eimparas/Electronic-DC-Load/Hardware/README.md

# Details about the design

## Analog Power Frontend
> Where the "work" happens

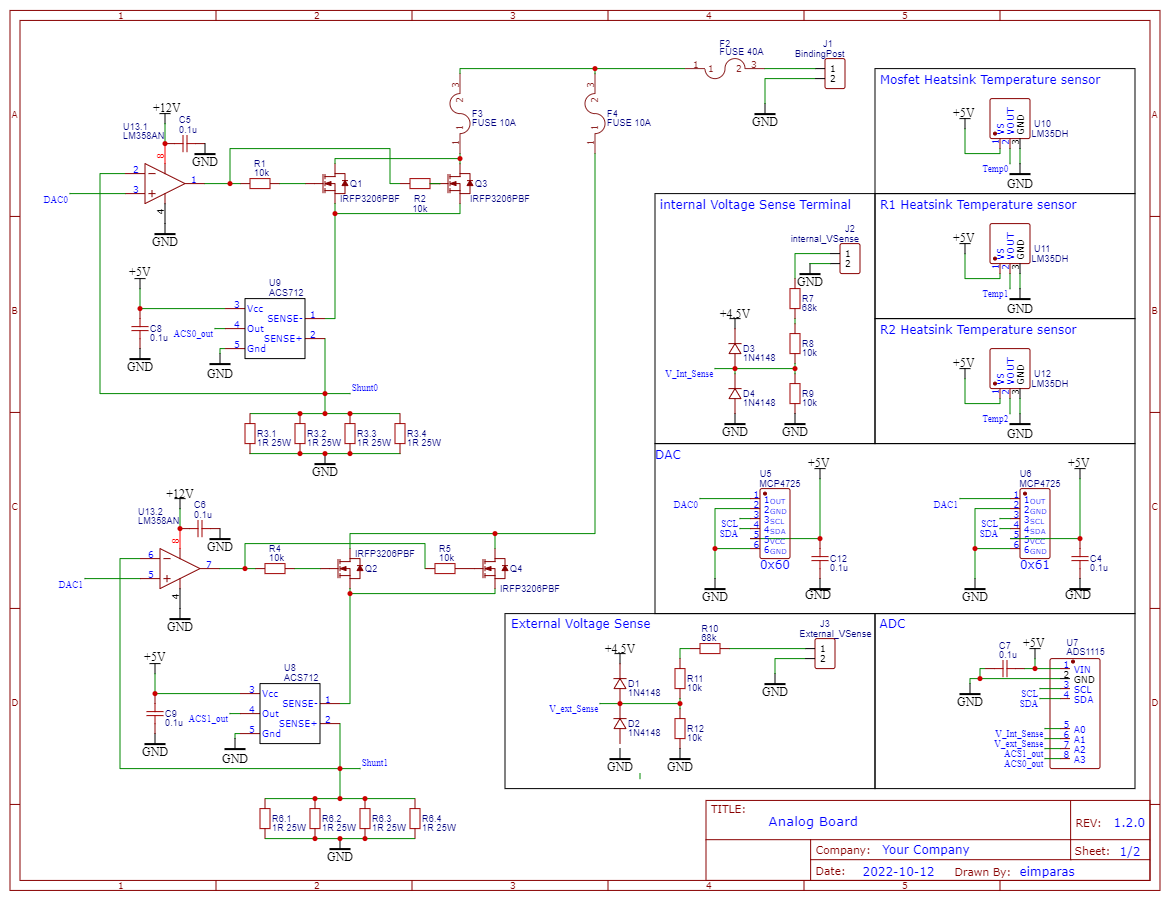
[picture p1: IMG/Analog_Power_Schematic.png]
Frontend


## Digital Control 
> adding the logic

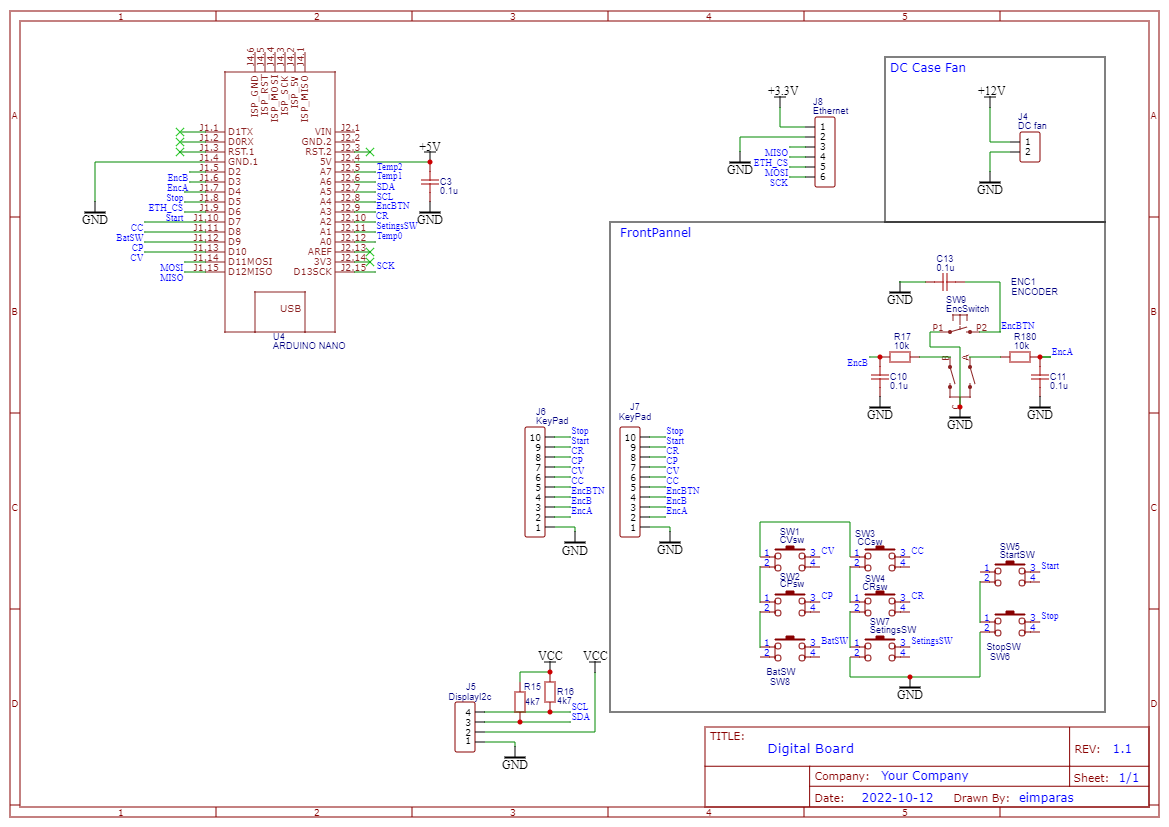
[picture p2: IMG/Digital_Control_Schematic.png]
Digital
