eimparas/Electronic-DC-Load/Specifications.md

|Voltage|Current|Maximum Power|Minimum Operating Voltage (DC)|
|-|-|-|-|
|1|2|3|4|

# Specifications
|Modes|Range|Programmable Resolution|Programmable Accuracy|
|-|-|-|-|
|CC|2|3|4|
|CV|
|CP|
|CR|
