eimparas/Electronic-DC-Load/IMG/Power Supply.png

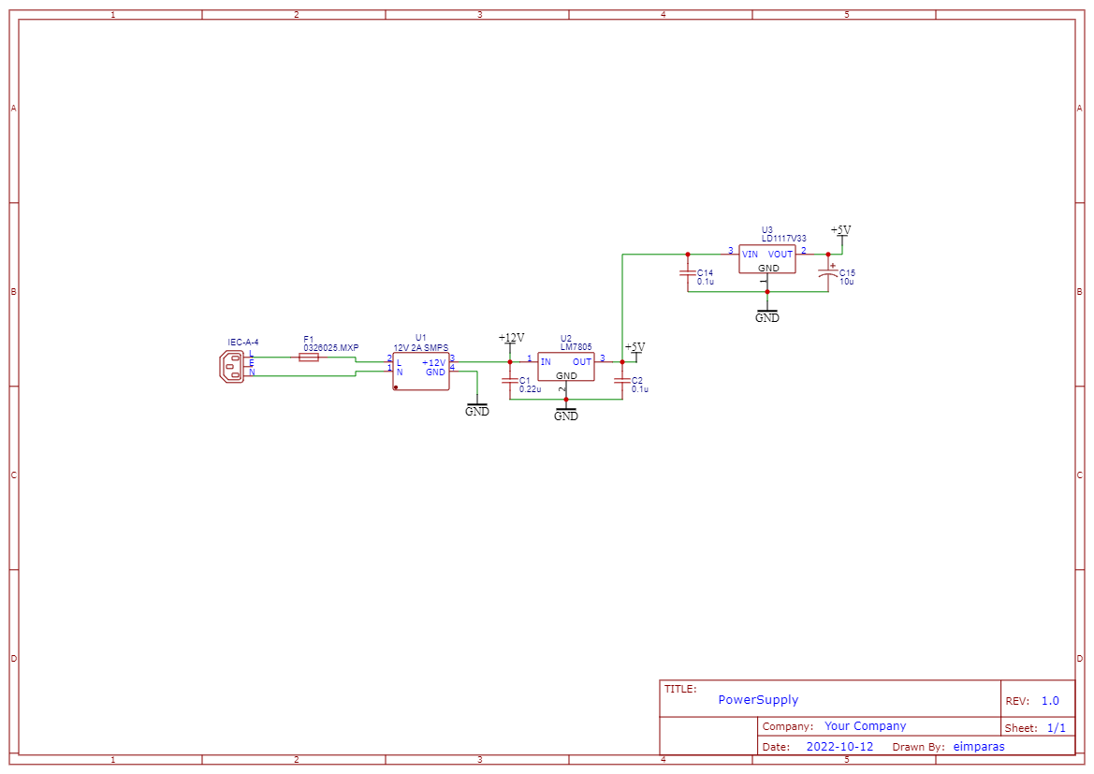
IMG/Power Supply.png
