eimparas/Electronic-DC-Load/Hardware/BOM.md

|ID |Name |Designator |Footprint |Quantity|
|---|---|---|---|---|
|1  |0.22u |C1 |TANT_A |1 |
|2  |0.1u |C2,C3,C4,C5,C6,C7,C8,C9,C10,C11,C12,C13,C14|C0603 |13 |
|3  |10u |C15 |CASE-A_3216 |1 |
|4  |1Ν4148 |D1,D2,D3,D4 |SOD-123_L2.8-W1.8-LS3.7-RD |4 |
|5  |ENCODER |ENC1 |PEC12_INCREMENTAL_ENCODER |1 |
|6  |0326025.MXP |F1 |FUSE-SMD_LITTELFUSE-0326025 |1 |
|7  |FUSE 40A |F2 |FUSE_5MM |1 |
|8  |FUSE 10A |F3,F4 |FUSE_5MM |2 |
|9  |BindingPost |J1 |HDR-F-2.54_1X2 |1 |
|10 |internal_VSense|J2 |HDR-F-2.54_1X2 |1 |
|11 |External_VSense|J3 |HDR-F-2.54_1X2 |1 |
|12 |DC fan |J4 |HDR-F-2.54_1X2 |1 |
|13 |DisplayI2c |J5 |HDR-M-2.54_1X4 |1 |
|14 |KeyPad |J6,J7 |HDR-M-2.54_1X10 |2 |
|15 |Ethernet |J8 |HDR-F-2.54_1X6 |1 |
|16 |IEC-A-4 |LINE1 |IEC-A-4 |1 |
|17 |IRFP3206PBF |Q1,Q2,Q3,Q4 |TO-247AC-3_L15.8-W5.0-P5.46-L  |4 |
|18 |10k |R1,R2,R4,R5,R8,R9,R11,R12,R17,R180 |RC06 |10 |
|19 |68k |R7,R10 |RC06 |2 |
|20 |4k7 |R15,R16 |RC06 |2 |
|21 |CVsw |SW1 |SW-SMD_4P-L6.0-W6.0-P3.90-LS9.5|1 |
|22 |CPsw |SW2 |SW-SMD_4P-L6.0-W6.0-P3.90-LS9.5|1 |
|23 |CCsw |SW3 |SW-SMD_4P-L6.0-W6.0-P3.90-LS9.5|1 |
|24 |CRsw |SW4 |SW-SMD_4P-L6.0-W6.0-P3.90-LS9.5|1 |
|25 |StartSW |SW5 |SW-SMD_4P-L6.0-W6.0-P3.90-LS9.5|1 |
|26 |StopSW |SW6 |SW-SMD_4P-L6.0-W6.0-P3.90-LS9.5|1 |
|27 |SetingsSW |SW7 |SW-SMD_4P-L6.0-W6.0-P3.90-LS9.5|1 |
|28 |BatSW |SW8 |SW-SMD_4P-L6.0-W6.0-P3.90-LS9.5|1 |
|29 |EncSwitch |SW9 |PEC12_INCREMENTAL_ENCODER |1 |
|30 |12V 2A SMPS |U1 |PWRM-TH_VB05-T2S12 |1 |
|31 |LM7805 |U2 |TO-220-3_L10.2-W4.5-P2.54-L |1 |
|32 |LD1117V33 |U3 |TO-220-3_L10.0-W4.5-P2.54-L |1 |
|33 |ARDUINO NANO |U4 |ARDUINO-NANO-3.0#ISP |1 |
|34 |MCP4725 |U5,U6 |MCP4725-B |2 |
|35 |ADS1115 |U7 |ADS1115 ADAFRUIT |1 |
|36 |ACS712 |U8,U9 |ACS712 |2 |
|37 |LM35DH |U10,U11,U12 |TO-CAN-3_BD5.5-P1.27-L |3 |
|38 |1R 25W |R3,R6 |RC42 |2 |
|39 |LM358AN |U13 |DIP-8_L9.8-W6.6-P2.54-LS7.6-BL |1 |
