eimparas/Electronic-DC-Load/Hardware/Schematics/Analog Power-frontend.pdf

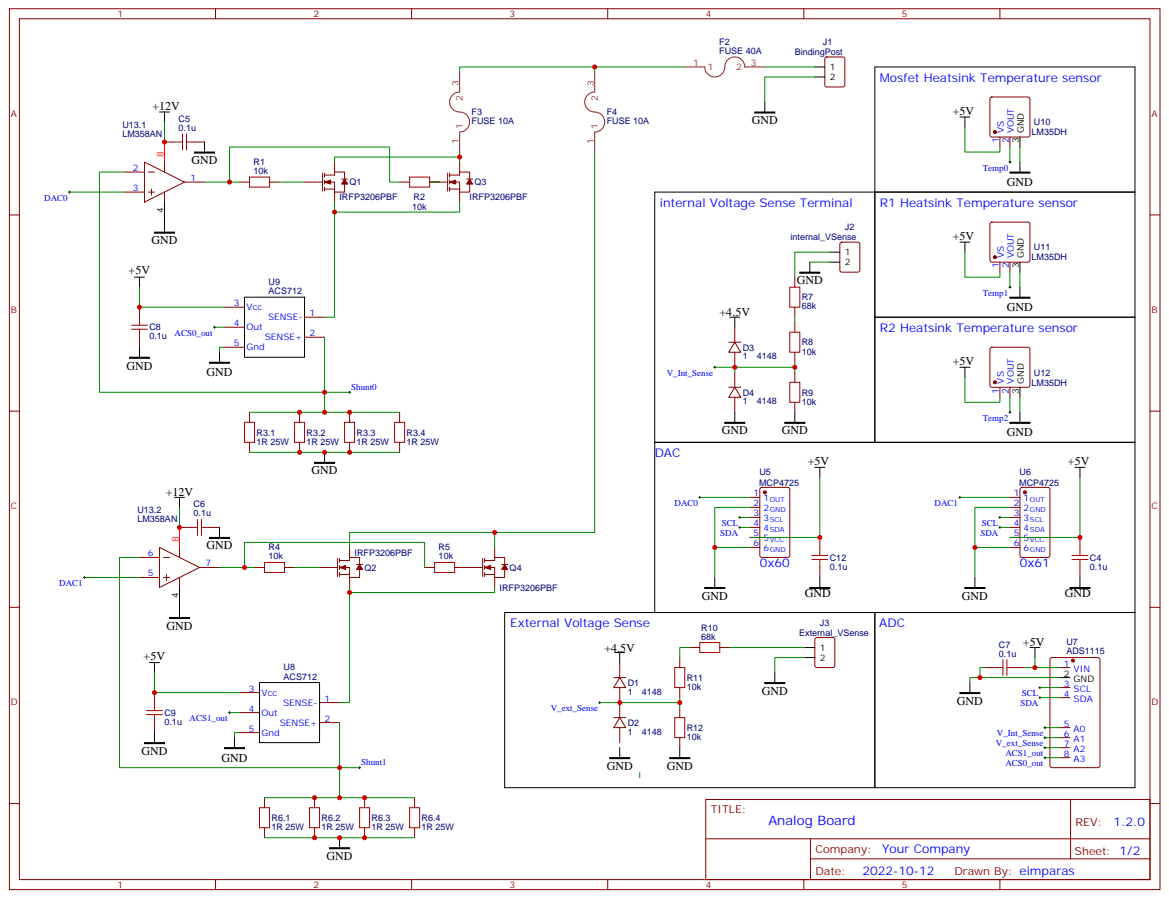
[picture p4: page 1]

Mosfet Heatsink Temperature sensor

internal Voltage Sense Terminal
