eimparas/Electronic-DC-Load/Hardware/Schematics/Digital Control.pdf

## DC Case Fan

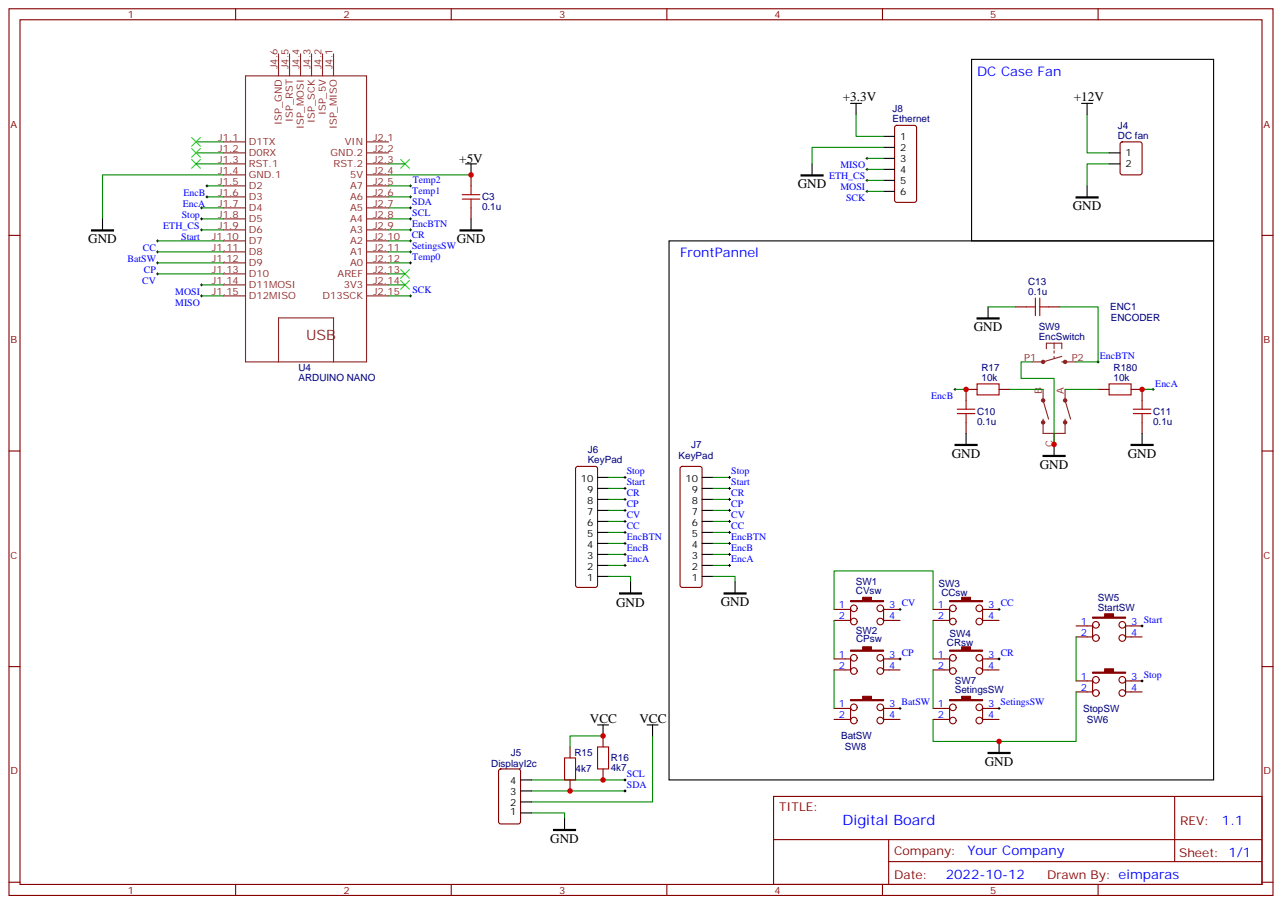
[picture p5: page 1]
