eimparas/Electronic-DC-Load/Hardware/Schematics/Power Supply.pdf

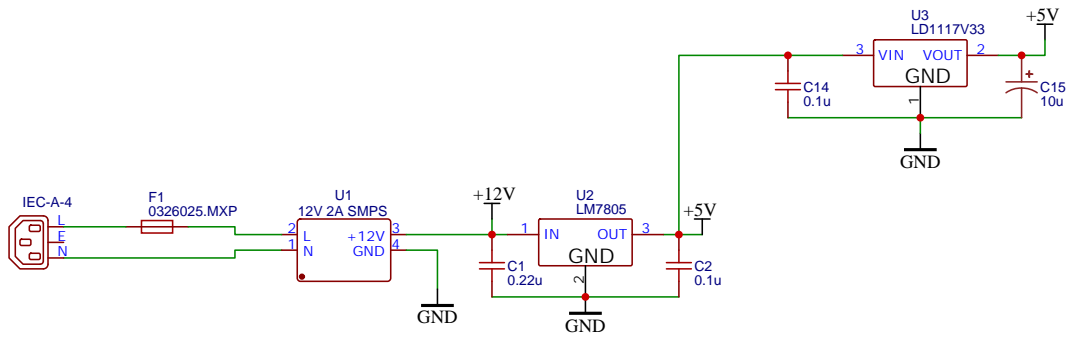
[picture p6: page 1]
