eimparas/Electronic-DC-Load/Firmware/ElectronicDCload/pinout.h

#ifndef PINOUT_H
#define PINOUT_H
#include <Arduino.h>
#endif

#define LCDaddr 0x27
#define ADCaddr 0x48
#define DAC1addr 0x62
#define DAC2addr 0x63



byte R[] = {
  B11111,
  B10011,
  B10101,
  B10011,
  B10101,
  B10101,
  B10101,
  B11111
};

byte V[] = {
  B11111,
  B11111,
  B10101,
  B10101,
  B10101,
  B11011,
  B11111,
  B11111
};

byte I[] = {
  B11111,
  B10001,
  B11011,
  B11011,
  B11011,
  B11011,
  B10001,
  B11111
};
byte C[] = {
  B11111,
  B11011,
  B10101,
  B10111,
  B10111,
  B10101,
  B11011,
  B11111
};
byte V2[] = {
  B11111,
  B10101,
  B10101,
  B10101,
  B10101,
  B10101,
  B11011,
  B11111
};//Noice

byte W[] = {
  B11111,
  B01110,
  B01110,
  B01110,
  B01010,
  B01010,
  B10001,
  B11111
};

byte A[] = {
  B10001,
  B01110,
  B01110,
  B01110,
  B00000,
  B01110,
  B01110,
  B11111
};

///
//Pins definitions , Use same names on schematics.
///

//encoder
#define EncA 2
#define EncB 3
#define EncBTN A3

//SCPI ethernet SPI cs
#define ETH_CS 5


//StartStopButtons
#define StopBtn 4 
#define StartBtn 6 


//modeButtons
#define CVbtn 10
#define CCbtn 7
#define CPbtn 9
#define CRbtn A2
#define BATsw 8

//SettingsSW
#define settingsSW A1

//LM35 HeatSink temperature Sensor
#define Temp0 A0
#define Temp1 A6
#define Temp2 A7//Mosfet

///
// Component Constants , Use same Names on schematics
///


//Voltage Divider Restistor Values

#define R7 68000
#define R8 10000
#define R9 10000//Internal Voltage Sense

#define R10 68000
#define R11 10000
#define R12 10000//External Voltage Sense
