eimparas/Electronic-DC-Load/(commit log)

2022-10-12 fixes in schematic export
2022-10-14 Pin Initialzations , initial rottery encoder function
    Rottery encoder is acting up , propably debuncing issue.
    [FrontPanel.ino, pinout.h]
2022-10-15 Working Encoder Code in `/Encoder` folder
2022-11-23 Changed shunt R, removed MUX , changed Current sense location
    With this arangement the circut can draw up to 20A per mosfet , this schematic has only one fet , can be scaled up .
    to measure total Current sum the `ACS_out` adc ports.
2022-12-08 Increased Current Capability , changed protection circuits
    Added a more effectvie way to protect the ADC from reverse or high voltages , removed the Emengercy button due to front pannel space , added 2 new temp sensors for the 2 new heatsinks . Removed the reading of Shunt voltage from the arduino's adc , we are just using now the ACS712 reading , since we updated the topology to support more amps.
2022-12-08 Working ADC example code
    working ADS1115 test code.Using the library from https://github.com/RobTillaart/ADS1X15 . This example is just some initial tests and exploration of the IC and its capabilities
2022-12-08 Initial Rottery encoder Tests
    using both External & PCint .
2022-12-08 Initial merge of Functions. GUI is formed .
    This is reference code for working LCD , rottery encoder , front pannel buttons .
2022-12-08 LM35 reports correct temperature . To be merged
2022-12-08 The first merge
    Mosfet Channel Control works, Voltage reading works but reports false info , Voltage divider equasion needs to be input, No Amps reading possibly Software issue.
    [TheFireTest.ino, pinout.h]
2023-01-12 Added mosfets in paralel in each channel
    To cunteract the huge power output of each mosfet, and bring it to a managable level i added a 2nd mosfet in paralel for each channel .
2023-01-20 Fixed component designators , Schematic cleanup ,
    Changed button order in BOM
2023-01-20 Added 3v3 regulator for Ethernet Controler
2023-02-24 Working CodeBase for atmega4809
    Operational:
    DAC
    ADC
    Screen
    Ethernet
    Initial SCPI parser
    ACS calibration function.
    0 CV,CC,CR,CP algorythms TBA
2023-02-25 Added Start Stop , Initial ModeButton BringUp ,
    Cleaned up code ,
    Added start Stop functionality
    Initial Mode button functionality , they are out of order ,work needed.
2023-02-26 Updated pin definitions
    - Added `A` character
    - Moved `CCbtn` from `D9` to `D7`
    - Moved `CPbtn` from `D8` to `D9`
    - Moved `CRbtn` from `D7` to `A2`
    - Renamed `BATbtn` to `BATsw` to match schematic
2023-02-26 Fixed mode swiching UI .
    Added pin initalzation for Battery modeButton
    Fixed mode swiching , issues with flickering
    [ElectronicDCload.ino]
2023-02-26 Added BatteryMode screen, Added SplashScreen
    - Added SplashScreen
    - Started to add the ability to Link DHCP even after `setup()`
    (non-operational ATM , gets IP from the DHCP server , but drops incoming connectios)
    - Added battery mode screen , (Buggy ATM , flickers and fails to clear screen when enters said mode )
    [ElectronicDCload.ino, pinout.h]
2023-03-01 Changed param storage type, Fixed BatteryMode *,Fixed flicker
    * Battery Mode needs change in the UI to be made more functional.
    [ElectronicDCload.ino]
2023-03-04 Added Battery Mode, Fixed code documentation, cleaned up
    -Removed the ability to Link DHCP even after `setup()` , This would slow down the Loop and degrade instrument responsivenets
    -Removed unused variables
    -Removed depricated/ commented out code
    -Added coments in code
    -Battery mode Screen Operational , Only Wh /Ah reading needs to be generated
    -Changed how encoder behaves , now it’s a fine coarse adjustment , not a digit by digit one.
    [ElectronicDCload.ino, pinout.h]
2023-03-06 Added Ah,Wh reading function, Started to add Enums
    -Changed how readVoltage() & readCurrent() is called.
    -Corrected Voltage Divider Formula
    -Started transision from intigers to enum …
    But enum failed me ..
    [ElectronicDCload.ino, pinout.h]
2023-03-12 implemented almost the command set .
    possible that the library cannot support all these commands , crashes whith 22 Commands
    [SCPI.ino]
2023-05-12 Added fuses to seperate and protect each channel
2023-05-12 Corrected Button order, Possibe pinout issue in J6
2023-06-14 Update Readme, Added BOM, Added specsheet template
