eimparas/Electronic-DC-Load/(notices)

Notices in the files:
README.md:
GPLv3 license
